jong0052/ECE4191Group1/homography_rooftop_nav/Images/Camera CallibrationImages/WIN_20230926_22_14_38_Pro.jpg

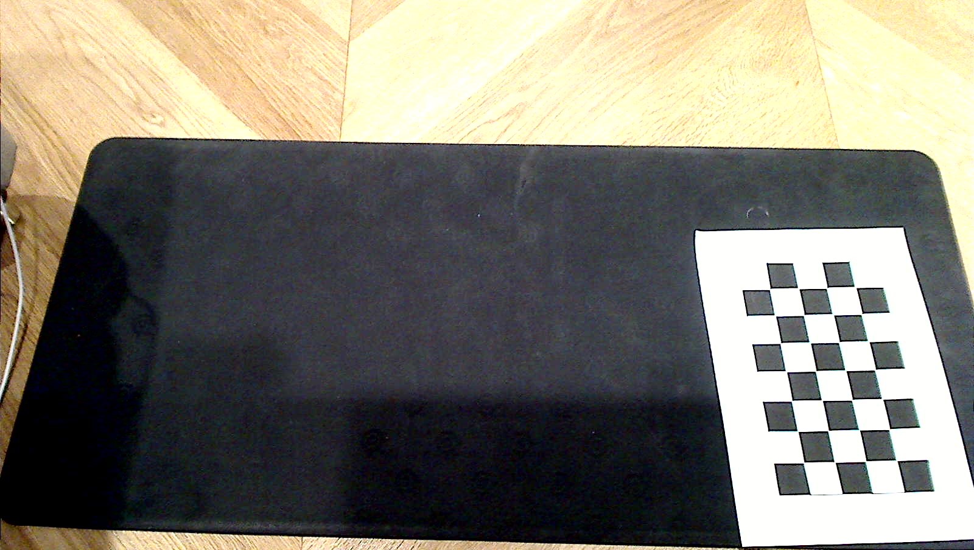
homography_rooftop_nav/Images/Camera CallibrationImages/WIN_20230926_22_14_38_Pro.jpg
