jong0052/ECE4191Group1/homography_rooftop_nav/Images/Roof Top Localisation/90 degree 200mm shift.jpg

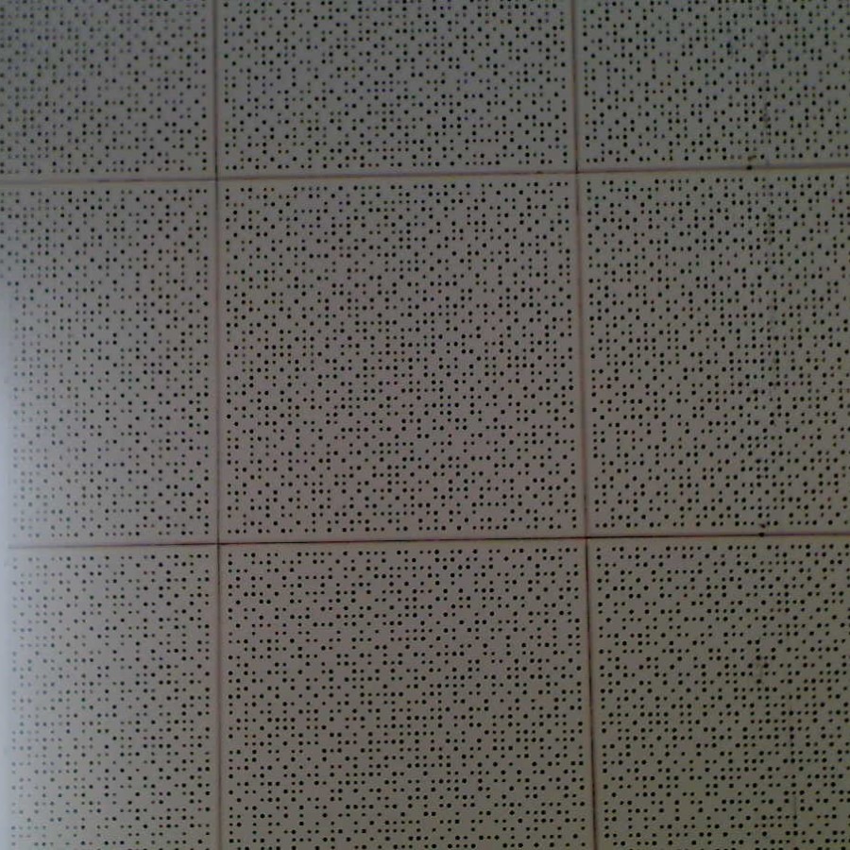
homography_rooftop_nav/Images/Roof Top Localisation/90 degree 200mm shift.jpg
