jong0052/ECE4191Group1/homography_rooftop_nav/Images/Roof Top Localisation/200mm shift.bak.jpg

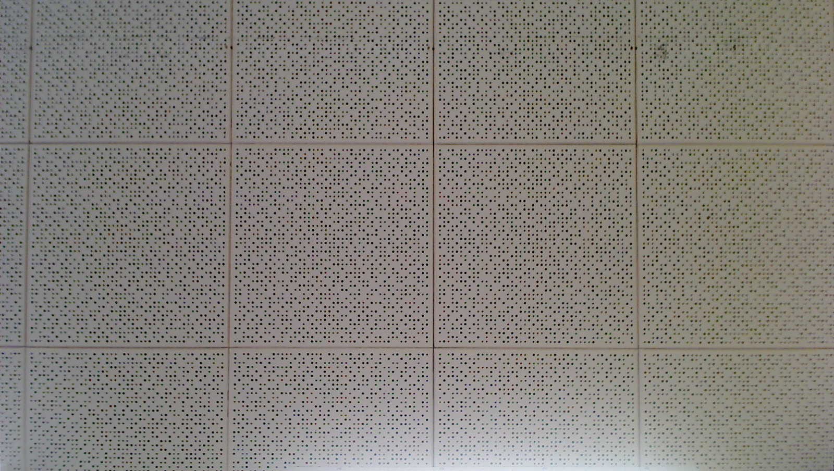
homography_rooftop_nav/Images/Roof Top Localisation/200mm shift.bak.jpg
