jong0052/ECE4191Group1/homography_rooftop_nav/Images/Roof Top Localisation/undistorted.jpeg

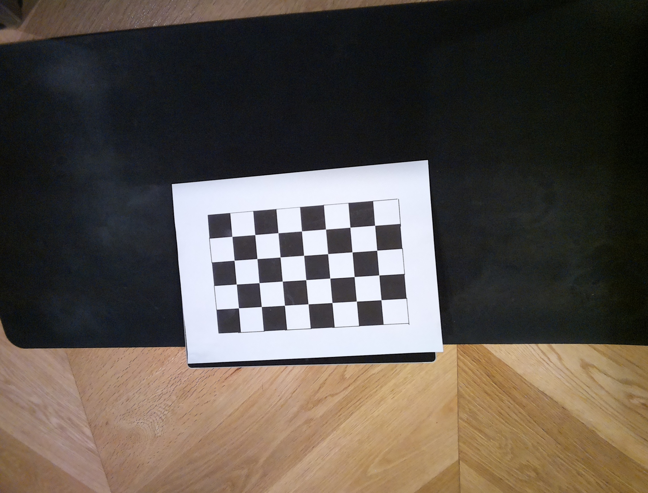
homography_rooftop_nav/Images/Roof Top Localisation/undistorted.jpeg
