jong0052/ECE4191Group1/test_code/Testing Code Sensor/Sensor Fusion.docx

# Sensor Fusion

- Phil’s Lab example
  - 3 Axis accelerometer and 3 Axis gyroscope.
  - Possibly applying a low-pass filter to the measurement.

Accelerometer Equations:

[a_x a_y a_z ]=(dv)/(dt)+w_b ×v-R*[00g]+β(t)+η(t)

- Where β(t) is the bias of the accelerometer and η(t) is the noise of the accelerometer.
- If we assume the body which the accelerometer is attached to is at rest:

[a_x a_y a_z ]=R*[00g]=[g*sin⁡(θ)-g*cos(θ)*sin⁡(ϕ)-g*cos(θ)*cos⁡(ϕ)]

- θ: Roll
- ϕ: Pitch
- γ: Yaw

Through variable cancellation.

ϕ_(acc) =tan^(-1) ((a_y)/(a_z))

θ_(acc) =sin^(-1) ((a_x)/g)

Gyroscope Equations:

Measure angular rate of rotation around body axes:

w_b =[p, q, r]

w_b =w_(true) +β(t)+η(t)

[ϕ θ]=[1, sin(ϕ)tan⁡(θ), cos(ϕ)tan⁡(θ)0, cos⁡(θ), -sin⁡(ϕ)][pqr]

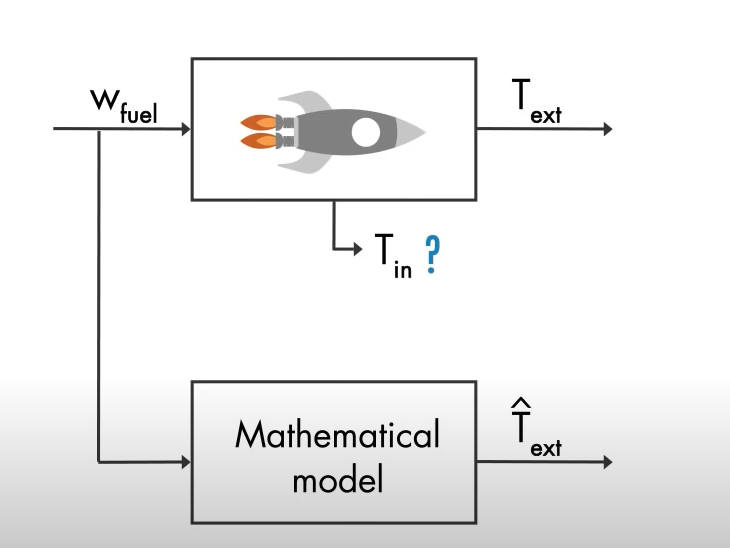
[picture p26: figure]
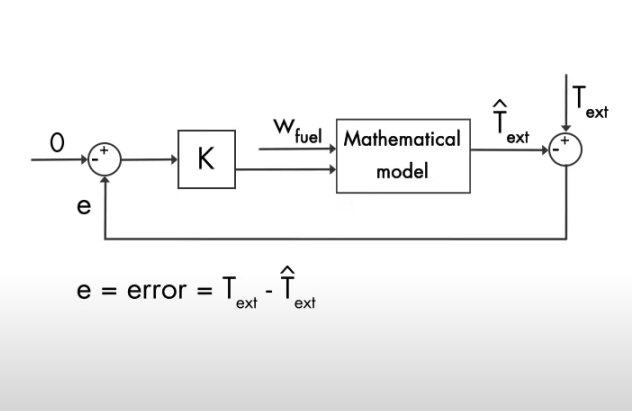
[picture p27: figure]
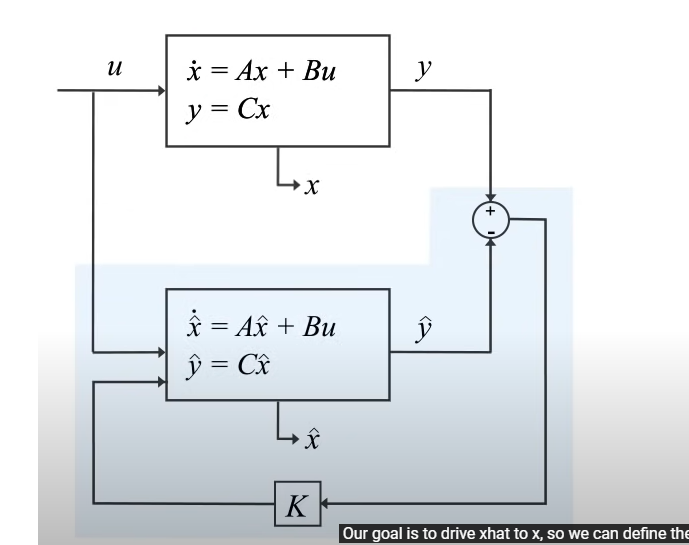
[picture p28: figure]

# Kalman Filter

Kalman Filter is a two step process, that starts from the prediction step.

x_(t+1) =Ax_t +u, u~N(0,P)

y_t =Hx_t +v, v~N(0,Q)

Surprise term is the difference between the measured velocity and the estimated velocity.

x=x_0 +v_0 ∆t+1/2∆t^2

x_(n+1) =x_n +vdn

- Where dn is the difference in time between two updates. ( z_n is some measurement of x_n )

z_n =x_n +v

- Time update: based on the current state of the system, we predict its new state. In the case of a train, this means predicting its next position based on its previous position and previous velocity.
- Measurement update: the prediction generated in the step before is corrected using the data from a sensor.
- We can calculate the standard deviation of the sensor through experimentation.
  - I propose an experiment that we go from 0 degree to 90 degree and 90 degree to 180 degree and take the measurement from that.

x_1 =x_0 (1-k_1 )+z_1 k_1

  - The above method is just linear interpolation, which is an interesting strategy.

Sensor Fusion:
