jong0052/ECE4191Group1/navigation.py

import numpy as np
from matplotlib import pyplot as plt
from IPython import display

from RRTC import RRTC
from Obstacle import *
from matplotlib.patches import Circle as C
from matplotlib.patches import Rectangle as R
import math
import serial
import time

import multiprocessing
from multiprocessing import Process, Value, Manager

# obstacles = [Rectangle((-0.05,0.0),0.1,0.4)]
obstacles = []

plotting = True
simulation = False

if not simulation:
    import RPi.GPIO as GPIO

    #start Luke's code
    # GPIO Mode (BOARD / BCM)
    GPIO.setmode(GPIO.BCM)

    # set GPIO Pins
    GPIO_TRIGGER1 = 23 # Right
    GPIO_ECHO1 = 24
    GPIO_TRIGGER2 = 17 # Left
    GPIO_ECHO2 = 27 # Left
    GPIO_TRIGGER3 = 5 # Middle
    GPIO_ECHO3 = 6 # Middle
    
    ECHO2_arr = [17, 5, 23]
    TRIG_arr = [27, 6, 24]
    # set GPIO direction (IN / OUT)
    GPIO.setup(GPIO_TRIGGER1, GPIO.OUT)
    GPIO.setup(GPIO_ECHO1, GPIO.IN)
    GPIO.setup(GPIO_TRIGGER2, GPIO.OUT)
    GPIO.setup(GPIO_ECHO2, GPIO.IN)
    GPIO.setup(GPIO_TRIGGER3, GPIO.OUT)
    GPIO.setup(GPIO_ECHO3, GPIO.IN)

class DiffDriveRobot:

    def __init__(self, inertia=5, drag=0.2, wheel_radius=0.055, wheel_sep=0.15,x=0,y=0,th=0):
        
        # States
        self.x = x  # x-position
        self.y = y  # y-position
        self.th = th  # orientation

        # Wheel States (Wheel Velocity, Inputs)
        self.wl = 0.0  # rotational velocity left wheel
        self.wr = 0.0  # rotational velocity right wheel

        # Constants
        self.I = inertia
        self.d = drag
        #self.dt=dt
        self.last = [time.time()]

        self.r = wheel_radius
        self.l = wheel_sep

    # Should be replaced by motor encoder measurement which measures how fast wheel is turning
    # Here, we simulate the real system and measurement
    def motor_simulator(self, w, duty_cycle, dt):
        torque = self.I * duty_cycle
        # print(torque)

        if (w > 0):
            w = min(w + dt * (torque - self.d * w), 3)
        elif (w < 0):
            w = max(w + dt * (torque - self.d * w), -3)
        else:
            w = w + dt * (torque)
        # print(f"dt: {dt} w: {w}")
        return w

    # Veclocity motion model
    def base_velocity(self, wl, wr):

        v = (wl * self.r + wr * self.r) / 2.0

        w = (wr * self.r - wl * self.r) / self.l

        return v, w

    # Kinematic motion model
    def pose_update(self, duty_cycle_l = 0, duty_cycle_r = 0, wl = 0, wr = 0):
        # print(self.last)
        dt = time.time() - self.last[-1]

        # print(duty_cycle_l)
        # print(duty_cycle_r)

        if (simulation): 
            self.wl = self.motor_simulator(self.wl, duty_cycle_l, dt)
            self.wr = self.motor_simulator(self.wr, duty_cycle_r, dt)
        else:
            self.wl = wl
            self.wr = wr
            # print(f"Current Wheel: {self.wl}, {self.wr}")

        v, w = self.base_velocity(self.wl, self.wr)

        self.x = self.x + dt * v * np.cos(self.th)
        self.y = self.y + dt * v * np.sin(self.th)
        self.th = self.th + w * dt

        self.last.append(time.time())
        self.last.pop(0)
        # print(self.last)
        # print(dt)
        # print(self.wl)
        # print(self.wr)

        return self.x, self.y, self.th

class RobotController:
    
    def __init__(self,Kp=0.1,Ki=0.01,wheel_radius=0.02, wheel_sep=0.1):
        
        self.Kp = Kp
        self.Ki = Ki
        self.r = wheel_radius
        self.l = wheel_sep
        self.e_sum_l = 0
        self.e_sum_r = 0
        
    def p_control(self,w_desired,w_measured,e_sum):
        
        duty_cycle = min(max(-1,self.Kp*(w_desired-w_measured) + self.Ki*e_sum),1)
        
        e_sum = e_sum + (w_desired-w_measured)
        
        return duty_cycle, e_sum
        
        
    def drive(self,v_desired,w_desired,wl,wr):
        
        wl_goal = (v_desired - self.l*w_desired/2)/self.r
        wr_goal = (v_desired + self.l*w_desired/2)/self.r
        
        duty_cycle_l,self.e_sum_l = self.p_control(wl_goal,wl,self.e_sum_l)
        duty_cycle_r,self.e_sum_r = self.p_control(wr_goal,wr,self.e_sum_r)
        
        return duty_cycle_l, duty_cycle_r, wl_goal, wr_goal
    
class TentaclePlanner:
    
    def __init__(self,dt=0.1,steps=5,alpha=1,beta=0.1, reverse=False):
        
        self.dt = dt
        self.steps = steps
        # Tentacles are possible trajectories to follow
        if (reverse):
            self.tentacles = [(0.0,1.0),(0.0,-1.0),(0.1,1.0),(0.1,-1.0),(0.1,0.5),(0.1,-0.5),(0.1,0.0),(0.0,0.0),(-0.1,1.0),(-0.1,-1.0),(-0.1,0.5),(-0.1,-0.5),(-0.1,0.0)]
        else:
            #self.tentacles = [(0.0,1.0),(0.0,-1.0),(0.1,1.0),(0.1,-1.0),(0.1,0.5),(0.1,-0.5),(0.1,0.0),(0.0,0.0)]
            self.tentacles = []
            for v in range(0,10, 1):
               for w in range(-10,10, 1):
                   self.tentacles.append((v/100, w/10))
            
            
            
            # print(self.tentacles)
  
        self.alpha = alpha
        self.beta = beta
    
    # Play a trajectory and evaluate where you'd end up
    def roll_out(self,v,w,goal_x,goal_y,goal_th,x,y,th, obstacles):
        
        for j in range(self.steps):
        
            x = x + self.dt*v*np.cos(th)
            y = y + self.dt*v*np.sin(th)
            th = (th + w*self.dt)
            
            if (self.check_collision(x,y,obstacles)):
                return np.inf
        
        # Wrap angle error -pi,pi
        e_th = goal_th-th
        e_th = np.arctan2(np.sin(e_th),np.cos(e_th))
        
        cost = self.alpha*((goal_x-x)**2 + (goal_y-y)**2) + self.beta*(e_th**2)
        
        return cost
    
    def check_collision(self,x,y,obstacles):
        min_dist = np.min(np.sqrt((x-obstacles[:,0])**2+(y-obstacles[:,1])**2))
        
        if (min_dist < 0.05):
            return True
        return False
        
    
    # Choose trajectory that will get you closest to the goal
    def plan(self,goal_x,goal_y,goal_th,x,y,th,obstacles):
        
        costs =[]
        for v,w in self.tentacles:
            costs.append(self.roll_out(v,w,goal_x,goal_y,goal_th,x,y,th,obstacles))
        
        best_idx = np.argmin(costs)
        best_costs = np.min(costs)

        # print(self.tentacles[best_idx])

        return self.tentacles[best_idx], best_costs

# This is NEW! (We coded this)


class Map:
    def __init__(self, width = 2, height = 2, true_obstacles = []):
        # Constants
        self.width = width
        self.height = height
        self.obstacle_dots = np.array([[100, 100]])
        self.true_obstacles = true_obstacles
        self.obstacle_size = 0.15
        self.obstacle_closest_threshold = 0.05

        self.initialize = True

    def update(self, robot_x, robot_y, robot_th, usLeft_update,usFront_update,  usRight_update, us_left=100, us_front=100, us_right=100):
        # Ultrasonic Distance
        if simulation:
            distance = self.check_ultrasonic(robot_x, robot_y, robot_th)
            self.generate_obstacle(robot_x, robot_y, robot_th, distance, 0, 0, 0)
        else:
            # us_left
            # self.generate_obstacle(robot_x, robot_y, robot_th, us_left, 0, 0, 0)

            # us_front
            if (usFront_update.value == 1):
                self.generate_obstacle(robot_x, robot_y, robot_th, us_front, 0, 0, 0)
                usFront_update.value = 0
                
            # us_front
            if (usLeft_update.value == 1):
                self.generate_obstacle(robot_x, robot_y, robot_th, us_left, -0.055, 0, 0)
                usLeft_update.value = 0
                
            # us_front
            if (usRight_update.value == 1):
                self.generate_obstacle(robot_x, robot_y, robot_th, us_right, 0.055, 0, 0)
                usRight_update.value = 0

            # # us_right
            # self.generate_obstacle(robot_x, robot_y, robot_th, us_right, 0, 0, 0)
        # Generate obstacles

    # Simulation
    def check_ultrasonic(self, robot_x, robot_y, robot_th):

        # Draw a line from robot to check true_obstacles
        curr_x = robot_x
        curr_y = robot_y
        distance = 0
        increment = 0.01
        hit = False
        
        while (not hit):
            # Increment curr_x and curr_y
            curr_x = curr_x + np.cos(robot_th) * increment
            curr_y = curr_y + np.sin(robot_th) * increment
            distance = distance + increment

            # Check curr_x and curr_y
            #min_dist = np.min(np.sqrt((curr_x-self.true_obstacles[:,0])**2+(curr_y-self.true_obstacles[:,1])**2))
            if (not self.is_collision_free(curr_x, curr_y)
                or np.abs(curr_x) > self.width / 2
                or np.abs(curr_y) > self.height / 2):
                # print(min_dist)
                # print(curr_x)
                # print(curr_y)
                # print(distance)
                hit = True

        return distance
    
    def is_collision_free(self, x, y):
        """
        Determine if nearby_node (new_node) is in the collision-free space.
        """
        points = np.vstack((x, y)).T
        for obs in self.true_obstacles:
            in_collision = obs.is_in_collision_with_points(points)
            if in_collision:
                return False
        
        return True  # safe

    def generate_obstacle(self, robot_x, robot_y, robot_th, distance, us_x=0, us_y=0, us_th=0):
        # def calc(rx, ry, theta, d, wx, wy,th):
        #     mat1 = np.array([[math.cos(theta), -1*math.sin(theta)],[math.sin(theta), math.cos(theta)]])
        #     mat2 = np.array([[math.cos(th), -1*math.sin(th)],[math.sin(th), math.cos(th)]])
        #     d_m = np.array([[d],
        #     [0]])
        #     r_m = np.array([[rx],
        #     [ry]])
        #     w_m = np.array([[wx],
        #     [wy]])
        #     return mat1@(mat2@d_m + r_m)+w_m

        # obs = calc(robot_x, robot_y, robot_th, distance, us_x, us_y, us_th)
        # print(obs)

        # Append to Obstacle_dots
        obs_x = robot_x + distance * np.cos(robot_th) + us_x * np.cos(robot_th - math.pi/ 2)
        obs_y = robot_y + distance * np.sin(robot_th) + us_x * np.sin(robot_th - math.pi/2)

        point = np.array([[obs_x, obs_y]])

        if (self.initialize):
            self.obstacle_dots = np.array([[2,2]])
            for i in range(-6, 7, 1):
                i = i / 10
                # Arena
                self.obstacle_dots= np.concatenate((self.obstacle_dots, np.array([[-0.6, i]])), axis=0)
                self.obstacle_dots= np.concatenate((self.obstacle_dots, np.array([[0.6, i]])), axis=0)
                self.obstacle_dots= np.concatenate((self.obstacle_dots, np.array([[i, -0.6]])), axis=0)
                self.obstacle_dots= np.concatenate((self.obstacle_dots, np.array([[i, 0.6]])), axis=0)
                # print("test")
            
            for i in range(0, 7, 1):
                i = i / 10
                # self.obstacle_dots= np.concatenate((self.obstacle_dots, np.array([[-0.05, i]])), axis=0)
                # self.obstacle_dots= np.concatenate((self.obstacle_dots, np.array([[0, i]])), axis=0)
                # self.obstacle_dots= np.concatenate((self.obstacle_dots, np.array([[0.05, i]])), axis=0)
                
            
            self.initialize = False
            #print(f"Obstacles: {self.obstacle_dots}")
        
        # print(self.obstacle_dots)
        # print(point)
        # If obstacle is within 0.01 of another point, don't add it to avoid clutter.
        for dot in self.obstacle_dots:
            # print(dot)
            # print(point)
            dx = dot[0] - point[0][0]
            dy = dot[1] - point[0][1]
            h = math.sqrt(dx ** 2 + dy ** 2)

            if h < self.obstacle_closest_threshold or obs_y < -0.1 or obs_x > 0.125 or obs_x < -0.125:
               return
            

        self.obstacle_dots= np.concatenate((self.obstacle_dots, point), axis=0)


    def get_obstacle_list(self):
        obstacle_list = []

        if (not self.initialize):
            for dot in self.obstacle_dots:
                obstacle_list.append(Circle(dot[0], dot[1], self.obstacle_size))

        return obstacle_list

    def get_obstacle_log(self):
        obstacle_list = []

        if (not self.initialize):
            for dot in self.obstacle_dots:
                obstacle_list.append([dot[0],dot[1]])

        return obstacle_list

class Serializer:
    def __init__(self):
        self.ser = serial.Serial('/dev/ttyUSB0', 115200, timeout=0.1)
        self.ser.reset_input_buffer()
        self.data = SerialData()

    def read(self):
        line = self.ser.readline().decode('utf-8', errors="ignore").rstrip()
        # print("serial read: " + str(line))
        self.decode_string(line)
    
    def write(self):
        self.ser.write(self.encode_string())
        # print("serial write: " + str(self.encode_string()))

    def decode_string(self,input_string):
        # Extracting numbers from the input_string using string manipulation
        # Line Format: "Wheels: [wl, wr]"
        if not input_string.startswith("Nano"):
            return
    
        try:
            start_idx = input_string.index("[") + 1
            end_idx = input_string.index("]")
            wl_current, wr_current, wl_goal, wr_goal = [float(num) for num in input_string[start_idx:end_idx].split(',')]
        except ValueError:
            raise ValueError("Invalid input format")

        # Creating a SerialData object with the extracted numbers
        self.data.update(wl_current=wl_current, wr_current=wr_current, wl_goal=wl_goal, wr_goal=wr_goal)
        
    
    def encode_string(self):
        return f"Pi: [{self.data.wl_current},{self.data.wr_current},{self.data.wl_goal},{self.data.wr_goal}]".encode("utf-8")

class SerialData:
    """
    Data for Serial Connection between Arduino and PI

    All Velocities in RPM
    """
    def __init__(self, wl_current=0, wr_current=0, wl_goal=0, wr_goal=0):
        self.update(wl_current, wr_current, wl_goal, wr_goal)

    def update(self, wl_current=None, wr_current=None, wl_goal=None, wr_goal=None):
        if wl_current is not None:
            self.wl_current = wl_current
        if wr_current is not None:
            self.wr_current = wr_current
        if wl_goal is not None:
            self.wl_goal = wl_goal
        if wr_goal is not None:
            self.wr_goal = wr_goal

class GoalSetter():
    def __init__(self):
        self.goals = []
        self.wait_times = []
        self.current_id = -1

        # Thresholds for reaching goal
        self.threshold = 1e-2
        self.alpha = 3 # x y factor
        self.beta = 0.1 # th factor

        # Goal time
        # self.threshold_time = 5
        # self.last = time.time()
        # self.accumulative_time = 0
        

    def get_current_goal(self):
        if (self.current_id < len(self.goals)):
            return self.goals[self.current_id]
        else:
            return []
       
    def get_current_wait(self):
        if (self.current_id < len(self.wait_times)):
            return self.wait_times[self.current_id]
        else:
            return 5
        
    def add_emergency_goal(self, goal_x, goal_y, goal_th):
        self.goals.insert(self.current_id, [goal_x, goal_y, goal_th])

    def add_new_goal(self, goal_x, goal_y, goal_th, wait_time = 5):
        self.goals.append([goal_x, goal_y, goal_th])
        self.wait_times.append(wait_time)
        
    def check_reach_goal(self, robot_x, robot_y, robot_th):
        goal_x, goal_y, goal_th = self.get_current_goal()

        e_th = goal_th-robot_th
        e_th = np.arctan2(np.sin(e_th),np.cos(e_th))
        
        cost = self.alpha*((goal_x-robot_x)**2 + (goal_y-robot_y)**2) + self.beta*(e_th**2)

        if cost < self.threshold:
            return True
            # dt = time.time() - self.last
            # self.accumulative_time += dt
            # self.last = time.time()

            # if (self.accumulative_time > self.threshold_time):
            #     self.accumulative_time = 0
            #     return True
            # else:
            #     return False
        else:
            return False
            # self.accumulative_time = 0
            # self.last = time.time()

    # Increment Goal. If there's another goal, return True. If ran out of goals, return False.
    def increment_goal(self):
        self.current_id += 1

        if (self.current_id < len(self.goals)):
            return True
        else:
            return False

def navigation_loop(wl_goal_value, wr_goal_value, poses, velocities, duty_cycle_commands, costs_vec, obstacle_data, rrt_plan_mp, robot_data, goal_data,current_wl, current_wr, usLeft_value, usFront_value, usRight_value, usFront_update):
    #obstacles = [Circle(0.5,0.5,0.05),Circle(-0.5, -0.5, 0.05), Circle(-0.5, 0.5, 0.05), Circle(0.5, -0.5, 0.05)]
    robot = DiffDriveRobot(inertia=10, drag=2, wheel_radius=0.0258, wheel_sep=0.22,x=-0.3,y=-0.4,th=0)
    controller = RobotController(Kp=2.0,Ki=0.15,wheel_radius=0.0258, wheel_sep=0.22)
    tentaclePlanner = TentaclePlanner(dt=0.1,steps=10,alpha=1,beta=1e-9)
    map = Map(1.2, 1.2, obstacles)
    goal_setter = GoalSetter()
    
    # goal_setter.add_new_goal(0.3,0.0, math.pi)
    goal_setter.add_new_goal(0, -0.3, math.pi/2, 1)
    goal_setter.add_new_goal(0.325, -0.3, math.pi/2, 1)
    goal_setter.add_new_goal(0.325, 0.2, math.pi, 10)
    # goal_setter.add_new_goal(0.325, 0.2, math.pi, 10)
    #goal_setter.add_new_goal(0.3, 0.2, -math.pi/2, 1)
    #goal_setter.add_new_goal(0.3, -0.2, math.pi, 1)
    #goal_setter.add_new_goal(-0.3, -0.2, math.pi/2, 1)
    goal_setter.add_new_goal(-0.3, 0.2, math.pi/2, 5)

    while goal_setter.increment_goal():
            
            final_goal = np.array(goal_setter.get_current_goal())
            print(f"New Goal: {final_goal}")
            start = np.array([robot.x, robot.y, robot.th])
            expand_dis = 0.05
            path_resolution = 0.01
            rrtc = RRTC(start = start, goal=final_goal, obstacle_list=map.get_obstacle_list(), width=map.width, height = map.height, expand_dis=expand_dis, path_resolution=path_resolution, max_points=200)
            rrt_plan = rrtc.planning()
            print(rrt_plan)
            rrt_plan_index = 0

            while (not goal_setter.check_reach_goal(robot.x, robot.y, robot.th)):
                
                # Map Generation for obstacles
                map.update(robot.x, robot.y, robot.th, usLeft_update, usFront_update,usRight_update, usLeft_value.value, usFront_value.value, usRight_value.value)
                # map.update(robot.x+0.055, robot.y, robot.th, usLeft_update, 100, usLeft_value.value, 100)
                # map.update(robot.x-0.055, robot.y, robot.th, usRight_update, 100, usRight_value.value, 100)

                temp_goal = rrt_plan[rrt_plan_index]
                if map.is_collision_free(robot.x, robot.y):
                    # print(map.obstacle_dots)

                    # Example motion using controller
                    tentacle,cost = tentaclePlanner.plan(temp_goal[0],temp_goal[1],temp_goal[2],robot.x,robot.y,robot.th, map.obstacle_dots)
                    v,w=tentacle
                else:
                    v, w = -0.1, 0
                    cost = np.inf
                    # if math.pi / 4 < robot.th < 3 * math.pi / 4:
                    #     GoalSetter.add_emergency_goal(goal_setter, robot.x, robot.y - 0.3)
                    # elif 3 * math.pi / 4 < robot.th < 5 * math.pi / 4:
                    #     GoalSetter.add_emergency_goal(goal_setter, robot.x + 0.3, robot.y)
                    # elif 5 * math.pi / 4 < robot.th < 7 * math.pi / 4:
                    #     GoalSetter.add_emergency_goal(goal_setter, robot.x, robot.y + 0.3)
                    # else:
                    #     GoalSetter.add_emergency_goal(goal_setter, robot.x - 0.3, robot.y)

                # print(f"v: {v} w: {w}")

                duty_cycle_l,duty_cycle_r,wl_goal,wr_goal = controller.drive(v,w,robot.wl,robot.wr)
                wl_goal_value.value = wl_goal
                wr_goal_value.value = wr_goal

                # Simulate robot motion - send duty cycle command to controller
                if (not simulation):
                    wl = ((current_wl.value/ 60)* 2*math.pi)
                    wr = ((current_wr.value/ 60)* 2*math.pi)
                    #* 60 /( 2*math.pi)
                    x,y,th = robot.pose_update(duty_cycle_l,duty_cycle_r, wl, wr)
                else:
                    x,y,th = robot.pose_update(duty_cycle_l,duty_cycle_r)

                # Have we reached temp_goal?
                if (cost < 1e-2):
                    if (rrt_plan_index < len(rrt_plan) - 1):
                        rrt_plan_index += 1

                rrtc.obstacle_list = map.get_obstacle_list()

                if (not rrtc.is_collision_free_path(rrt_plan)):
                    start = np.array([robot.x, robot.y, robot.th])

                    # print("why are u runnin")
                    rrtc = RRTC(start = start, goal=final_goal, obstacle_list=map.get_obstacle_list(), width=map.width, height = map.height, expand_dis=expand_dis, path_resolution=path_resolution)
                    new_rrt_plan = rrtc.planning()

                    if (len(new_rrt_plan) > 0):
                        rrt_plan = new_rrt_plan
                        rrt_plan_index = 0

                # Log data
                poses.append([x,y,th])
                duty_cycle_commands.append([duty_cycle_l,duty_cycle_r])
                velocities.append([robot.wl,robot.wr])
                costs_vec.append(cost)
                obstacle_data[:] = []
                obstacle_data.extend(map.get_obstacle_log())
                rrt_plan_mp[:] = []
                rrt_plan_mp.extend(rrt_plan)
                robot_data[:] = []
                robot_data.extend([robot.x, robot.y, robot.th])
                goal_data[:] = []
                goal_data.extend(goal_setter.get_current_goal())
                
                #print("loop 1")
                

                

            # Hardcode wait for Milestone 1
            print(f"Reached Goal {goal_setter.current_id}, I am going to wait for {goal_setter.get_current_wait()} seconds.")
            start_wait = time.time()
            total_wait = goal_setter.get_current_wait()
            dt = 0

            while (dt <= total_wait):
                dt = time.time() - start_wait
                v, w = 0, 0

                duty_cycle_l,duty_cycle_r,wl_goal,wr_goal = controller.drive(v,w,robot.wl,robot.wr)
                wl_goal_value.value = wl_goal
                wr_goal_value.value = wr_goal

                # Simulate robot motion - send duty cycle command to controller
                if (not simulation):
                    wl = (current_wl.value / 60) * 2*math.pi
                    wr = (current_wr.value / 60) * 2 * math.pi
                    x,y,th = robot.pose_update(duty_cycle_l,duty_cycle_r, wl, wr)
                else:
                    x,y,th = robot.pose_update(duty_cycle_l,duty_cycle_r)

                # Log data
                poses.append([x,y,th])
                robot_data[:] = []
                robot_data.extend([robot.x, robot.y, robot.th])
                
                time.sleep(0.1)

def distance(trig, echo, pin = 1):
        # set Trigger to HIGH
        
        GPIO.output(trig, True)

            # set Trigger after 0.01ms to LOW
        if (pin == 1):
            time.sleep(0.00001)
        elif (pin == 2):
            time.sleep(0.000005)
        else:
            time.sleep(0.000006)
        GPIO.output(trig, False)

        StartTime = time.time()
        StopTime = time.time()
        timeout = time.time()
        timeout_threshold = 0.01

            # save StartTime
        while GPIO.input(echo) == 0 and (time.time()- timeout) < timeout_threshold:
            StartTime = time.time()
                # print("start")

            # save time of arrival
        while GPIO.input(echo) == 1 and (time.time() - timeout) < timeout_threshold:
            StopTime = time.time()
                # print("stop")

            # time difference between start and arrival
        TimeElapsed = StopTime - StartTime
            # multiply with the sonic speed (34300 cm/s)
            # and divide by 2, because there and back
        dist = (TimeElapsed * 34300) / 2

        return dist

def multi_dist (num_samp = 3, trig = GPIO_TRIGGER3, echo = GPIO_ECHO3, pin =  1):
    dist_vec = []
    print_vec = []

    for i in range(5):
        for i in range (num_samp):
            dist = distance(trig , echo, pin)
            if (dist >= 5 and dist <=50):
                dist_vec.append(dist)
            else:
                dist_vec.append(200)
        mean_dist = np.mean(dist_vec)
        print_vec.append(mean_dist)
    result = np.median(print_vec)
    return result

def usLoop(GPIO_TRIGGER1, GPIO_ECHO1, GPIO_TRIGGER2, GPIO_ECHO2, GPIO_TRIGGER3, GPIO_ECHO3, usLeft_value, usFront_value, usRight_value, usLeft_update, usFront_update, usRight_update):
    while True:
        value = []
        value.append(multi_dist(3, GPIO_TRIGGER2, GPIO_ECHO2,  1) / 100) 
        value.append(multi_dist(3, GPIO_TRIGGER3, GPIO_ECHO3,  2) / 100)
        value.append(multi_dist(3, GPIO_TRIGGER1, GPIO_ECHO1,  3) / 100)
        print("Left:" + str(value[2])+ " Middle:" + str(value[1]) + "Right" + str(value[0]))
 
            # print(value)
        #if (value[1] > 0.05 and value[1] < 0.50):
        usLeft_value.value = value[2] + 0.11
        usFront_value.value = value[1] + 0.12
        usRight_value.value = value[0] + 0.12
        usLeft_update.value = 1
        usFront_update.value = 1
        usRight_update.value = 1
        print("accepted")
        #else:
         #   usFront_value.value = 2
          #  usLeft_value.value = 2
           # usRight_value.value = 2
           # usLeft_update.value = 1
           # usFront_update.value = 1
           # usRight_update.value = 1
           # print("rejected")
    
        # print(usFront_value.value)
        time.sleep(0.01)
    #   usLeft_value.value = distance(GPIO_TRIGGER1, GPIO_ECHO1)
    #   usRight_value.value = distance(GPIO_TRIGGER2, GPIO_ECHO2)

def serializer_loop(wl_goal_value, wr_goal_value, current_wl, current_wr):
    serializer = Serializer()
    while True:
        
        # Read Data
        # serializer.read()
        wl_goal_rpm = wl_goal_value.value * 60 / (2 * math.pi)
        wr_goal_rpm = wr_goal_value.value * 60 / (2 * math.pi)
        # print(wl_goal_rpm)
        # print(wr_goal_rpm)
        serializer.data.update(wl_goal=wl_goal_rpm, wr_goal=wr_goal_rpm)
        serializer.write()
        time.sleep(0.01)
        serializer.read()

        # print("loop 2")
        current_wl.value = serializer.data.wl_current
        current_wr.value = serializer.data.wr_current
        
        #print("loop 2")

def plotting_loop(poses, obstacle_data, rrt_plan, robot_data, goal_data):
    poses_local = []
    obstacle_data_local = []
    robot_data_local = []
    rrt_plan_local = []
    goal_data_local = []

    while True:
        time.sleep(0.5)

        poses_local_unstable = poses[:]
        robot_data_local_unstable = robot_data[:]
        rrt_plan_local_unstable = rrt_plan[:]
        obstacle_data_local_unstable = obstacle_data[:]
        goal_data_local_unstable = goal_data[:]

        if (len(poses_local_unstable) > 0):
            poses_local= poses_local_unstable

        if (len(robot_data_local_unstable) > 0):
            robot_data_local = robot_data_local_unstable

        if (len(obstacle_data_local_unstable) > 0):
            obstacle_data_local = obstacle_data_local_unstable

        if (len(rrt_plan_local_unstable) >0):
            rrt_plan_local = rrt_plan_local_unstable
            
        if (len(goal_data_local_unstable) >0):
            goal_data_local = goal_data_local_unstable

        if (not(len(poses_local) > 0 and len(robot_data_local) > 0 and len(obstacle_data_local) > 0 and len(rrt_plan_local) > 0) and len(goal_data_local) > 0):
            print("Failed to plot, empty data...")
            continue

        # Plot robot data
        plt.clf()
        ax = plt.gca()
        for obstacle in obstacles:
            if isinstance(obstacle,Circle):
                patch = C((obstacle.center[0], obstacle.center[1]), obstacle.radius, fill=False, edgecolor='blue')
            elif isinstance(obstacle,Rectangle):
                patch = R((obstacle.origin[0],obstacle.origin[1]),obstacle.width,obstacle.height,fill=True,edgecolor='pink')
            ax.add_patch(patch)

        #plt.subplot(1,3,1)
        # print(poses_local)
        plt.plot(np.array(poses_local)[:,0],np.array(poses_local)[:,1])
        plt.plot(robot_data_local[0], robot_data_local[1],'k',marker='+')
        plt.quiver(robot_data_local[0],robot_data_local[1],0.1*np.cos(robot_data_local[2]),0.1*np.sin(robot_data_local[2]))
        plt.plot(goal_data_local[0],goal_data_local[1],'x',markersize=5)
        plt.quiver(goal_data_local[0],goal_data_local[1],0.1*np.cos(goal_data_local[2]),0.1*np.sin(goal_data_local[2]))

        np_obstacle_data = np.array(obstacle_data_local)
        plt.plot(np_obstacle_data[:,0],np_obstacle_data[:,1],'ko',markersize=5)
        plt.xlim(-1,1)
        plt.ylim(-1,1)
        plt.xlabel('x-position (m)')
        plt.ylabel('y-position (m)')
        plt.grid()

        plan_x_data = []
        plan_y_data = []
        plan_th_data = []

        for i in range(len(rrt_plan_local)):
            plan_x_data = np.append(plan_x_data, rrt_plan_local[i][0])
            plan_y_data = np.append(plan_y_data, rrt_plan_local[i][1])
            plan_th_data = np.append(plan_th_data, rrt_plan_local[i][2])

        plt.quiver(plan_x_data,plan_y_data,0.1*np.cos(plan_th_data),0.1*np.sin(plan_th_data), color="r")

        #plt.plot(obstacles[:,0],obstacles[:,1],'bo',markersize=15,alpha=0.2)
        plt.xlim(-1,1)
        plt.ylim(-1,1)
        plt.xlabel('x-position (m)')
        plt.ylabel('y-position (m)')
        plt.grid()

        plt.pause(0.05)
        plt.show(block=False)

        display.clear_output(wait=True)
        display.display(plt.gcf())
        
        # print("loop 3")
        

if __name__ == '__main__':
    manager = Manager()

    poses = manager.list()
    velocities = manager.list()
    duty_cycle_commands = manager.list()
    costs_vec = manager.list()
    obstacle_data = manager.list()
    rrt_plan = manager.list()
    robot_data = manager.list()
    goal_data = manager.list()

    # Multiprocessing
    wl_goal_value = Value('f',0)
    wr_goal_value = Value('f',0)
    current_wl = Value('f',0)
    current_wr = Value('f',0)
    usLeft_value = Value('f', 100)
    usLeft_update = Value('f', 0)
    usFront_value = Value('f', 100)
    usFront_update = Value('f', 0)
    usRight_value = Value('f', 100)
    usRight_update = Value('f', 0)
    
    proc1 = Process(target=navigation_loop,args=(wl_goal_value,wr_goal_value, poses, velocities, duty_cycle_commands, costs_vec, obstacle_data, rrt_plan, robot_data, goal_data, current_wl, current_wr, usLeft_value, usFront_value, usRight_value, usFront_update))

    if not simulation:
        proc2 = Process(target=serializer_loop, args=(wl_goal_value,wr_goal_value,current_wl, current_wr))
        procUS = Process(target=usLoop, args=(GPIO_TRIGGER1, GPIO_ECHO1, GPIO_TRIGGER2, GPIO_ECHO2, GPIO_TRIGGER3, GPIO_ECHO3, usLeft_value, usFront_value, usRight_value, usLeft_update, usFront_update, usRight_update))
    if plotting:
        proc3 = Process(target=plotting_loop, args=(poses, obstacle_data, rrt_plan, robot_data, goal_data))

    proc1.start()
    if not simulation:
        proc2.start()
        procUS.start()
    if plotting:
        proc3.start()

    proc1.join()
    if not simulation:
        proc2.join()
        procUS.join()
    if plotting:
        proc3.join()
    

     
