jong0052/ECE4191Group1/Obstacle.py

import numpy as np
from math_functions import *

class Polygon:
    """
    Obstacles are represented as polygons
    Polygons are defined as an array with n rows (vertices) and 2 columns

    Points needs to be defined in Clockwise fashion
    """

    def __init__(self, vertices=np.zeros((4,2))):
        self.vertices = vertices
        self.inner_vertices = None

    def compute_distance_point_to_polygon(self, point_q,ccw):
        """
        Compute distance from point_q to the closest point in the polygon

        Method returns:
        - dist: minimal distance from point_q to polygon
        - indices of segment closest to point_q

        """        
        dist = np.inf
        segment_idx = None
        closest_point = None
        len_polygon = self.vertices.shape[0]
        
        if ccw:
            for i in range(len_polygon):
                case, seg_dist, _ = compute_distance_point_to_segment(self.vertices[(i+1) % len_polygon],self.vertices[i], point_q)
                if seg_dist <= dist:
                    dist = seg_dist
                    if case == 0:
                        closest_point = (i+1) % len_polygon
                    elif case == 1:
                        closest_point = (i+1) % len_polygon
                    else:
                        closest_point = i  

            segment_idx = (closest_point, (closest_point+len_polygon-1) % len_polygon)
            # print("Closest segment is {}, {}".format(segment_idx[0], segment_idx[1]))
            
        else:
            for i in range(len_polygon):
                case, seg_dist, _ = compute_distance_point_to_segment(self.vertices[i],self.vertices[(i+1) % len_polygon], point_q)
                if seg_dist <= dist:
                    dist = seg_dist
                    if case == 0:
                        closest_point = i
                    elif case == 1:
                        closest_point = i
                    else:
                        closest_point = (i+1) % len_polygon   

            segment_idx = (closest_point, (closest_point+1) % len_polygon)
            # print("Closest segment is {}, {}".format(segment_idx[0], segment_idx[1]))
        return dist, segment_idx

    def compute_tangent_vector_to_polygon(self, point_q, idx):  
        
        """
        Determines the unit-length vector tangent at point_q to the polygon
        
        Method returns:
           tangent vector

        """  
 
        v1 = self.vertices[idx[0]]
        v2 = self.vertices[idx[1]]
        
        case, seg_dist, closest_point = compute_distance_point_to_segment(v1, v2, point_q)
        
        tangent_vector = (v2-v1)/np.linalg.norm(v2-v1)
        
        return tangent_vector

    def compute_inner_vertices(self, offset):
        print("Reee")
        num_points = self.vertices.shape[0]
        candidates = []
        tangent_lines = []
        baseline = []
        for i in range(num_points):
            left = self.vertices[i]
            origin = self.vertices[(i + 1) % num_points]
            right = self.vertices[(i + 2) % num_points]
            left_v = (left - origin)/np.linalg.norm(left - origin)
            right_v = (right - origin)/np.linalg.norm(right - origin)
            bisector = (left_v + right_v)/np.linalg.norm(left_v + right_v)
            angle_modifier = 1/np.sin(np.arcsin(np.cross(left_v, right_v))/2)
            candidates.append([
                origin + offset * bisector * angle_modifier,
                origin - offset * bisector * angle_modifier])
            tangent_lines.append(right_v)
            baseline.append(origin)
        polies = []
        for i in range(2):
            poly = []
            poly.append(candidates[0][i])
            for i in range(1,num_points,1):
                check_parallel = (poly[i-1] - candidates[i][0]) @ tangent_lines[i]
                if np.isclose(check_parallel, 0):
                    poly.append(candidates[i][0])
                else:
                    poly.append(candidates[i][1])
            polies.append(np.array(poly))
            
        self.inner_vertices =  polies[int(polygonArea(polies[1][:, 0], polies[1][:, 1], num_points)
                         < polygonArea(polies[0][:, 0], polies[1][:, 1], num_points))]
        return self.inner_vertices


    def is_in_collision_with_points(self, points, min_dist=0.01):
        # First check if point is within polygon
        points_in_collision = []
        
        for point in points:
            count_collisions = 0
            p_x, p_y = point
            for i in range(self.vertices.shape[0]-2):
                j = i - 1 if i != 0 else self.vertices.shape[0]-2
                v1 = self.vertices[i]
                v2 = self.vertices[j]

                if ((v1[1] > p_y) != (v2[1] > p_y)) and (p_x < (v2[0] - v1[0]) * (p_y - v1[1]) / (v2[1] - v1[1] + v1[0])):
                    count_collisions += 1

            if count_collisions % 2 == 1:
                points_in_collision.append(point)

        if len(points_in_collision):
            return True

        # Second check if point is in collision with edges
        # print(points)
        dist, _ = self.compute_distance_point_to_polygon(points[-1], False)
        if dist < min_dist:
            # print("Collision found!")
            # print(dist)
            # print(min_dist)
            # print("oof")
            return True

        return False


    def get_perimeter(self):

        perimeter = 0

        for i in range(self.vertices.shape[0]-1):
            v1 = self.vertices[i]
            v2 = self.vertices[i+1]

            perimeter += compute_distance_between_points(v1, v2)

        return perimeter


class Rectangle(Polygon):

    def __init__(self, origin=np.zeros(2), width=100, height=20):
        self.width = width
        self.height = height
        self.origin = origin

        v1 = origin
        v4 = origin + np.array([width, 0])
        v2 = origin + np.array([width, height])
        v3 = origin + np.array([0, height])

        Polygon.__init__(self, vertices=np.array([v1, v2, v3, v4]))

    def to_display_format(self, screen_height):
        return (self.origin[0], self.origin[1], self.width, self.height)

    def plot_obstacle(self):
        return super().plot_obstacle()


class Circle:
    
    def __init__(self, c_x, c_y, radius):
        self.center = np.array([c_x, c_y])
        self.radius = radius

    def is_in_collision_with_points(self, points):

        dist = []
        for point in points:
            dx = self.center[0] - point[0]
            dy = self.center[1] - point[1]

            dist.append(dx * dx + dy * dy)

        if np.min(dist) <= self.radius ** 2:
            return True

        return False  # safe
