jong0052/ECE4191Group1/arduino/Pico-10DOF-IMU_Rev2_1/imu.h

#ifndef __IMU_H
#define __IMU_H

#include <stdint.h>
#include <Arduino_GFX_Library.h>

#ifdef __cplusplus
extern "C" {
#endif

  typedef enum
  {
      IMU_EN_SENSOR_TYPE_NULL = 0,
      IMU_EN_SENSOR_TYPE_MPU9250,
      IMU_EN_SENSOR_TYPE_MAX
  }IMU_EN_SENSOR_TYPE;

  typedef struct imu_st_angles_data_tag
  {
      float fYaw;
      float fPitch;
      float fRoll;
  }IMU_ST_ANGLES_DATA;

  typedef struct imu_st_sensor_data_tag
  {
      int16_t s16X;
      int16_t s16Y;
      int16_t s16Z;
  }IMU_ST_SENSOR_DATA;

  typedef struct icm20948_st_avg_data_tag
  {
    uint8_t u8Index;
    int16_t s16AvgBuffer[8];
  }ICM20948_ST_AVG_DATA;

  void imuInit(IMU_EN_SENSOR_TYPE *penMotionSensorType, Arduino_GFX *gfx);
  void imuDataGet(IMU_ST_ANGLES_DATA *pstAngles, 
          IMU_ST_SENSOR_DATA *pstGyroRawData,
          IMU_ST_SENSOR_DATA *pstAccelRawData,
          IMU_ST_SENSOR_DATA *pstMagnRawData); 
  void imuAHRSupdate(float gx, float gy, float gz, float ax, float ay, float az, float mx, float my, float mz);
  float invSqrt(float x);

#ifdef __cplusplus
}
#endif

#endif
