jong0052/ECE4191Group1/test_code/Testing Code Sensor/i2cTest.ino

/*
* Brian R Taylor
* brian.taylor@bolderflight.com
* 
* Copyright (c) 2021 Bolder Flight Systems Inc
*
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
* THE SOFTWARE IS PROVIDED “AS IS”, WITHOUT WARRANTY OF ANY KIND, EXPRESS OR
* IMPLIED, INCLUDING BUT NOT LIMITED TO THE WARRANTIES OF MERCHANTABILITY,
* FITNESS FOR A PARTICULAR PURPOSE AND NONINFRINGEMENT. IN NO EVENT SHALL THE
* AUTHORS OR COPYRIGHT HOLDERS BE LIABLE FOR ANY CLAIM, DAMAGES OR OTHER
* LIABILITY, WHETHER IN AN ACTION OF CONTRACT, TORT OR OTHERWISE, ARISING
* FROM, OUT OF OR IN CONNECTION WITH THE SOFTWARE OR THE USE OR OTHER DEALINGS
* IN THE SOFTWARE.
*/

#include "mpu9250.h"

/* Mpu9250 object */
bfs::Mpu9250 imu;

void setup() {
  /* Serial to display data */
  Serial.begin(115200);
  while(!Serial) {}
  /* Start the I2C bus */
  Wire.begin();
  Wire.setClock(400000);
  /* I2C bus,  0x68 address */
  imu.Config(&Wire, bfs::Mpu9250::I2C_ADDR_PRIM);
  /* Initialize and configure IMU */
  if (!imu.Begin()) {
    Serial.println("Error initializing communication with IMU");
    while(1) {}
  }
  /* Set the sample rate divider */
  if (!imu.ConfigSrd(19)) {
    Serial.println("Error configured SRD");
    while(1) {}
  }
}

void loop() {
  /* Check if data read */
  if (imu.Read()) {
    Serial.print(imu.new_imu_data());
    Serial.print("\t");
    Serial.print(imu.new_mag_data());
    Serial.print("\t");
    Serial.print(imu.accel_x_mps2());
    Serial.print("\t");
    Serial.print(imu.accel_y_mps2());
    Serial.print("\t");
    Serial.print(imu.accel_z_mps2());
    Serial.print("\t");
    Serial.print(imu.gyro_x_radps());
    Serial.print("\t");
    Serial.print(imu.gyro_y_radps());
    Serial.print("\t");
    Serial.print(imu.gyro_z_radps());
    Serial.print("\t");
    Serial.print(imu.mag_x_ut());
    Serial.print("\t");
    Serial.print(imu.mag_y_ut());
    Serial.print("\t");
    Serial.print(imu.mag_z_ut());
    Serial.print("\t");
    Serial.print(imu.die_temp_c());
    Serial.print("\n");
    Serial.println();
  }
}
