jong0052/ECE4191Group1/test_code/serial_test.py

#!/usr/bin/env python3
import serial
import time
if __name__ == '__main__':
    ser = serial.Serial('/dev/ttyUSB0', 9600, timeout=1)
    ser.reset_input_buffer()
    while True:
        ser.write(b"Hello from Raspberry Pi!\n")
        # print("hello")
        line = ser.readline().decode('utf-8').rstrip()
        print(line)
        time.sleep(1)
