jong0052/ECE4191Group1/(commit log)

2023-08-09 A Ultrasonic Simulation with Map Generation
2023-08-16 Epic RRT Fail Combo
    [RRTC.py, navigation.py]
2023-08-19 Arduino Motor Driver
    - This is the commit of the Arduino Motor Driver
2023-08-23 Delete PID_speed_control.ino
    Deleted the out PID speed controller which is not working for some reason
    [PID_speed_control.ino]
2023-08-26 Update code to less printing
2023-08-28 Fix PID
2023-08-30 Fixed Real Time Operating
    [navigation.py]
2023-09-02 Calibration attempt
2023-09-04 Ultrasonic Test
2023-10-03 More Bug fixing and Path Attempts
    [AStar.py, const.py, navigation_loop.py, plotting_loop.py]
2023-10-14 IMU and Sensor
    Kill me
2023-10-14 Servo code
2023-10-14 Servo Packager
2023-10-14 no more ultrasonic
2023-10-14 Okay, begone ultrasonic
2023-10-16 Maybe? Gyro-ness?
2023-10-16 ok actually use imu
    wargh
2023-10-16 Slightly more print
2023-10-16 servo? Maybe?
2023-10-16 Servo Testr code
2023-10-16 no longer clearing GPIO
    [RFID.py, navigation_loop.py]
2023-10-16 Servo stop being dumb
2023-10-17 yide if you broke this Istg
    [navigation_loop.py]
2023-10-22 I2C Scan
2024-03-08 Attached Report
